randyzr/Graduation_Project/Project Tracking/README.md

# Seguimiento del proyecto

Este espacio resume el avance del proyecto de graduación y facilita su revisión por parte de la persona asesora y la persona lectora. La información se actualiza cada dos semanas y enlaza las afirmaciones de avance con evidencia verificable dentro del repositorio.

> **Estado de este tablero:** borrador inicial. Los porcentajes, fechas calendario y responsables deben confirmarse en la primera revisión con las personas profesoras.

## Resumen ejecutivo

| Elemento | Estado actual |
|---|---|
| Fecha de corte | 17 de agosto de 2026 |
| Última actualización | [Actualización 01](Biweekly%20Updates/2026-08-17_Update_01.md) |
| Periodicidad propuesta | Cada dos semanas |
| Estado general | Por confirmar con base en los entregables y la evidencia existente |
| Próximo hito | Por definir |
| Retroalimentación pendiente | Ver [seguimiento de retroalimentación](03_Feedback_Tracker.md) |

## Avance por objetivo

El porcentaje no se asigna por percepción. Se calcula con base en entregables terminados y aceptados. El detalle y el método de cálculo se encuentran en [avance por objetivos](01_Objective_Progress.md).

| Objetivo específico | Avance | Estado | Evidencia principal |
|---|---:|---|---|
| 1. Arquitectura e integración física | Por calcular | En revisión inicial | [Evidencia O1](Evidence/Objective%201/README.md) |
| 2. Identificación y adquisición ESD | Por calcular | En revisión inicial | [Evidencia O2](Evidence/Objective%202/README.md) |
| 3. Interfaz, almacenamiento y reportes | Por calcular | En revisión inicial | [Evidencia O3](Evidence/Objective%203/README.md) |
| 4. Validación funcional | Por calcular | En revisión inicial | [Evidencia O4](Evidence/Objective%204/README.md) |

## Accesos rápidos

- [Avance por objetivos](01_Objective_Progress.md)
- [Cronograma y principales hitos](02_Project_Schedule.md)
- [Seguimiento de retroalimentación](03_Feedback_Tracker.md)
- [Uso responsable de inteligencia artificial](04_Responsible_AI_Use.md)
- [Actualizaciones quincenales](Biweekly%20Updates/)
- [Evidencia organizada por objetivo](Evidence/)

## Criterios de estado

| Estado | Significado |
|---|---|
| No iniciado | No existe trabajo verificable del entregable |
| En progreso | Existe trabajo parcial y evidencia asociada |
| En revisión | El entregable está listo para recibir observaciones |
| Bloqueado | Existe un impedimento documentado |
| Completado | El criterio de aceptación fue verificado |

## Cómo revisar este espacio

1. Abrir la actualización quincenal más reciente.
2. Revisar los cambios en avance, cronograma, riesgos y retroalimentación.
3. Seguir los enlaces hacia la evidencia correspondiente.
4. Registrar nuevas observaciones en el seguimiento de retroalimentación.
