randyzr/Graduation_Project/Project Tracking/Evidence/Objective 1/README.md

# Evidencia del objetivo 1

Use este índice para enlazar evidencia existente sin duplicar innecesariamente archivos del repositorio.

| Entregable | Evidencia | Fecha | Estado de verificación |
|---|---|---|---|
| Requerimientos y criterios de diseño | Por enlazar | Por completar | Pendiente |
| Arquitectura y diagramas | Por enlazar | Por completar | Pendiente |
| Alimentación y pines | Por enlazar | Por completar | Pendiente |
| PCB | Por enlazar | Por completar | Pendiente |
| CAD y prototipo físico | Por enlazar | Por completar | Pendiente |
