randyzr/Graduation_Project/Documentation_Latex/body/glosario.tex

\chapter*{Glosario}
\addcontentsline{toc}{chapter}{Glosario}

\begin{description}

\item[ANSI] Instituto Nacional Estadounidense de Normalización.

\item[CDM] Modelo de dispositivo cargado.

\item[CSV] Valores separados por comas.

\item[EMI] Interferencia electromagnética.

\item[EPA] Área protegida contra descargas electrostáticas.

\item[ESD] Descarga electrostática.

\item[ESP-NOW] Protocolo de comunicación inalámbrica entre dispositivos de la familia ESP32.

\item[GPIO] Entrada o salida digital de propósito general.

\item[HBM] Modelo de cuerpo humano.

\item[HMI] Interfaz humano-máquina.

\item[HR] Humedad relativa.

\item[I2C] Bus de comunicación serial Inter-Integrated Circuit.

\item[IEC] Comisión Electrotécnica Internacional.

\item[JEDEC] Consejo Conjunto de Ingeniería de Dispositivos Electrónicos.

\item[MM] Modelo de máquina.

\item[PCB] Tarjeta de circuito impreso.

\item[RFID] Identificación por radiofrecuencia.

\item[RTC] Reloj de tiempo real.

\item[SD] Secure Digital.

\item[microSD] Factor de forma compacto del estándar SD.

\item[SPI] Interfaz periférica serial.

\item[TEM] Test, Engineering and Manufacturing.

\item[UART] Transmisor-receptor asíncrono universal.

\end{description}
