randyzr/Graduation_Project/Documentation_Latex/body/notation.tex

\chapter*{Notación}
\addcontentsline{toc}{chapter}{Notación}

\begin{description}

\item[$C$] Capacitancia.

\item[$f$] Frecuencia de la señal eléctrica.

\item[$I$] Corriente eléctrica.

\item[$I_{\mathrm{Body}}$] Corriente que circula a través del cuerpo del usuario durante la prueba.

\item[$I_{\mathrm{fuga}}$] Corriente de fuga presente en el circuito o en la tarjeta electrónica.

\item[$IF$] Tasa de integración funcional.

\item[$q$] Carga eléctrica.

\item[$R$] Resistencia eléctrica.

\item[$R_{\mathrm{Body}}$] Resistencia eléctrica del cuerpo del usuario a tierra.

\item[$R_{\mathrm{ref}}$] Resistencia de referencia utilizada en el circuito de medición.

\item[$TZ$] Índice de trazabilidad.

\item[$V$] Tensión eléctrica.

\item[$V_{\mathrm{Body}}$] Tensión medida en el cuerpo del usuario durante la prueba.

\item[$V_s$] Tensión de estímulo aplicada al circuito de medición.

\item[$X$] Reactancia eléctrica.

\item[$Z$] Impedancia eléctrica.

\item[$Z_{\mathrm{Cuerpo}}$] Impedancia eléctrica equivalente del cuerpo humano.

\end{description}
