randyzr/Graduation_Project/Documentation_Latex/body/Portada.tex

%% ---------------------------------------------------------------------------
%% titlepage_licce_es.tex
%%
%% Title page
%%
%% $Id: titlepage.tex 1452 2010-07-07 00:55:16Z palvarado $
%% ---------------------------------------------------------------------------

\thispagestyle{empty} 

\begin{center}

Tecnológico de Costa Rica

\par\vspace{1ex}

Escuela de Ingeniería Electrónica

\par\vspace{1ex}

Programa de Licenciatura en Ingeniería Electrónica

\par\vspace{20mm}



\par\vspace*{\fill}

{\large\bf{\thesisTitle}}

\par\vspace*{\fill}

Informe de Proyecto de Graduación para optar por el título de

Ingeniero en Electrónica con el grado académico de Licenciatura

\par\vspace{20mm}

\thesisAuthor 

Asesor: M.Sc.-Ing.\, Javier Rivera Alvarado

Campus Tecnológico Local San Carlos

\vspace*{\fill}

\ifdraft{%
{ \today}
}{
San Carlos,  Mayo, 2026
}
\end{center}
\newpage 
\cleardoublepage 

%%% Local Variables: 
%%% mode: latex
%%% TeX-master: "main"
%%% End:
