randyzr/Graduation_Project/Project Tracking/Evidence/Objective 2/README.md

# Evidencia del objetivo 2

| Entregable | Evidencia | Fecha | Estado de verificación |
|---|---|---|---|
| Flujo de identificación y adquisición | Por enlazar | Por completar | Pendiente |
| Código de barras | Por enlazar | Por completar | Pendiente |
| Reconocimiento facial | Por enlazar | Por completar | Pendiente |
| Estados `LO`, `OK` y `HI` | Por enlazar | Por completar | Pendiente |
| Pruebas funcionales | Por enlazar | Por completar | Pendiente |
