randyzr/Graduation_Project/Project Tracking/Evidence/Objective 3/README.md

# Evidencia del objetivo 3

| Entregable | Evidencia | Fecha | Estado de verificación |
|---|---|---|---|
| Interfaz gráfica | Por enlazar | Por completar | Pendiente |
| Flujo y estructura de datos | Por enlazar | Por completar | Pendiente |
| Almacenamiento, consulta y reportes | Por enlazar | Por completar | Pendiente |
| Pruebas funcionales | Por enlazar | Por completar | Pendiente |
