randyzr/Graduation_Project/Project Tracking/Evidence/Objective 4/README.md

# Evidencia del objetivo 4

| Entregable | Evidencia | Fecha | Estado de verificación |
|---|---|---|---|
| Procedimiento y criterios | Por enlazar | Por completar | Pendiente |
| Evaluación de pruebas individuales | Por enlazar | Por completar | Pendiente |
| Pruebas de integración | Por enlazar | Por completar | Pendiente |
| Cálculos de `TZ` e `IF` | Por enlazar | Por completar | Pendiente |
| Informe de validación | Por enlazar | Por completar | Pendiente |
