randyzr/Graduation_Project/Project Tracking/02_Project_Schedule.md

# Cronograma

| Actividad | Inicio | Fin estimado | Duración | Objetivo relacionado | Estado actual |
|---|---:|---:|---:|---|---|
| Prototipo versión 2.0 terminado | Semana 3 | Semana 9 | 7 semanas | O1–O3 | Por actualizar |
| Desarrollo general del proyecto | Semana 3 | Semana 14 | 12 semanas | O1–O4 | Por actualizar |
| Informe preliminar del proyecto | Semana 5 | Semana 10 | 6 semanas | O1–O3 | Por actualizar |
| Pruebas en laboratorio TEM | Semana 9 | Por definir | Por definir | O4 | Por actualizar |
