randyzr/Graduation_Project/Project Tracking/01_Objective_Progress.md

# Avance por objetivos

Fuente de los objetivos y entregables: `Documentation/GP_Official_Doc/body/Hipot_y_Obj.tex`.

## Método de medición

Cada entregable tiene el mismo peso dentro de su objetivo en este primer borrador. El porcentaje se calcula así:

```text
avance del objetivo = entregables completados / entregables totales × 100
```

## Objetivo específico 1

**Objetivo:** Diseñar la arquitectura electrónica, de comunicación, alimentación e integración física de la estación, con base en los requerimientos funcionales y no funcionales del sistema.

| Entregable | Criterio de aceptación propuesto | Estado | Evidencia | Observaciones |
|---|---|---|---|---|
| Especificación de requerimientos y criterios de diseño | Requerimientos identificables, verificables y relacionados con el diseño | Por revisar | [Evidencia O1](Evidence/Objective%201/README.md) | Confirmar evidencia existente |
| Arquitectura electrónica y diagramas de bloques e interconexión | Subsistemas, interfaces y protocolos claramente identificados | Por revisar | [Evidencia O1](Evidence/Objective%201/README.md) | |
| Sistema de alimentación y distribución de pines | Tensiones, protecciones, consumo y pines documentados | Por revisar | [Evidencia O1](Evidence/Objective%201/README.md) | |
| PCB diseñadas, fabricadas y verificadas | Archivos de diseño y resultados de verificación eléctrica disponibles | Por revisar | [Evidencia O1](Evidence/Objective%201/README.md) | |
| Modelo CAD y prototipo físico ensamblado | Modelo disponible y ensamblaje documentado con evidencia visual | Por revisar | [Evidencia O1](Evidence/Objective%201/README.md) | |

**Avance calculado:** por determinar después de revisar la evidencia.

## Objetivo específico 2

**Objetivo:** Diseñar e implementar los subsistemas de identificación de usuarios y adquisición del resultado de la prueba ESD, mediante la integración del lector de código de barras, el reconocimiento facial complementario y las señales del probador HZR-171.

| Entregable | Criterio de aceptación propuesto | Estado | Evidencia | Observaciones |
|---|---|---|---|---|
| Flujo de identificación y adquisición ESD documentado | El flujo y sus estados pueden seguirse de inicio a fin | Por revisar | [Evidencia O2](Evidence/Objective%202/README.md) | Confirmar evidencia existente |
| Identificación por código de barras funcional | Se lee y valida el identificador en pruebas documentadas | Por revisar | [Evidencia O2](Evidence/Objective%202/README.md) | |
| Reconocimiento facial complementario | Registro y reconocimiento funcionan bajo condiciones documentadas | Por revisar | [Evidencia O2](Evidence/Objective%202/README.md) | |
| Adquisición de estados `LO`, `OK` y `HI` | Cada estado se adquiere y reporta correctamente en pruebas | Por revisar | [Evidencia O2](Evidence/Objective%202/README.md) | |
| Pruebas funcionales de identificación y adquisición | Resultados, incidencias y conclusiones están documentados | Por revisar | [Evidencia O2](Evidence/Objective%202/README.md) | |

**Avance calculado:** por determinar después de revisar la evidencia.

## Objetivo específico 3

**Objetivo:** Diseñar e implementar la interfaz gráfica que guíe al usuario durante el ciclo de prueba y el sistema de almacenamiento de los resultados y generación de reportes históricos trazables.

| Entregable | Criterio de aceptación propuesto | Estado | Evidencia | Observaciones |
|---|---|---|---|---|
| Interfaz gráfica táctil funcional | El usuario completa el flujo previsto y recibe mensajes claros | Por revisar | [Evidencia O3](Evidence/Objective%203/README.md) | Confirmar evidencia existente |
| Flujo de interacción y estructura de datos documentados | Estados, transiciones y campos del registro están definidos | Por revisar | [Evidencia O3](Evidence/Objective%203/README.md) | |
| Almacenamiento, consulta y reportes históricos | Los registros completos pueden guardarse, consultarse y exportarse | Por revisar | [Evidencia O3](Evidence/Objective%203/README.md) | |
| Pruebas funcionales de interacción y gestión de información | Resultados, incidencias y conclusiones están documentados | Por revisar | [Evidencia O3](Evidence/Objective%203/README.md) | |

**Avance calculado:** por determinar después de revisar la evidencia.

## Objetivo específico 4

**Objetivo:** Validar el desempeño funcional del prototipo mediante pruebas individuales de los subsistemas y pruebas de integración del sistema completo, utilizando los indicadores de trazabilidad e integración funcional definidos para el proyecto.

| Entregable | Criterio de aceptación propuesto | Estado | Evidencia | Observaciones |
|---|---|---|---|---|
| Procedimiento y criterios de aceptación | Casos, datos, ambiente, pasos y criterios están definidos antes de validar | Por revisar | [Evidencia O4](Evidence/Objective%204/README.md) | Confirmar evidencia existente |
| Evaluación consolidada de pruebas individuales | Los resultados de los subsistemas se resumen y analizan | Por revisar | [Evidencia O4](Evidence/Objective%204/README.md) | |
| Pruebas de integración documentadas | Existen resultados reproducibles del ciclo completo | No iniciado | [Evidencia O4](Evidence/Objective%204/README.md) | Confirmar fecha y laboratorio |
| Índices `TZ` e `IF` calculados | Datos, fórmulas, cálculos y resultados son trazables | No iniciado | [Evidencia O4](Evidence/Objective%204/README.md) | |
| Informe de validación | Incluye cumplimiento, incidencias, limitaciones y conclusiones | No iniciado | [Evidencia O4](Evidence/Objective%204/README.md) | |

**Avance calculado:** por determinar después de revisar la evidencia.
