randyzr/Graduation_Project/Documentation_Latex/main.tex

%%%%%%%%%%%%%%%%%%%%%%%%%%%%%%%%%%%%%%%%%%%%%%%%%%%%%%%%%%%%%%%%%%%%%%%%%%%%%%%
% Author:  Pablo Alvarado
%
% Escuela de Ingeniería Electrónica
% Instituto Tecnológico de Costa Rica
%
% Tesis de Licenciatura
% 
% Phone:   +506 2550 9005
% email:   palvarado@itcr.ac.cr
%
%%%%%%%%%%%%%%%%%%%%%%%%%%%%%%%%%%%%%%%%%%%%%%%%%%%%%%%%%%%%%%%%%%%%%%%%%%%%%%%

% \documentclass is book
% If you want a printable two-side version of the thesis
%\documentclass[12pt,twoside,letterpaper]{book}

% If you want an electronic-only version of the thesis, do it one-sided
\documentclass[12pt,oneside,letterpaper]{book}

\usepackage[utf8]{inputenc}
\usepackage{ifthen}       % provide if-then-else operators
\usepackage{subcaption}
\usepackage[siunitx]{circuitikz}
\usepackage{siunitx}
\usepackage{tabularx}
\usepackage{float}
\usepackage{array}
\usepackage{pgfgantt}
\usepackage{pdflscape}
\usepackage{xcolor}
\usepackage{rotating}
\usepackage{booktabs}

\usepackage[backend=biber]{biblatex}
\addbibresource{literatura.bib}
%\addbibresource{literatura.bib}z
% --------------------------------------------------------------------------
% Global variables required in document formatting
% --------------------------------------------------------------------------
%
% BOOK MODE
%
\newboolean{bookmode}                  % boolean used to control book format
% Ensure that only one of the next two lines is active:
\setboolean{bookmode}{true}           % turn book mode on
%\setboolean{bookmode}{false}           % turn book mode off

%
% DRAFT MODE
%   The draft mode activates the TODO index and some "draft" markings all
%   around.  Ensure you set it to false for the final version!!
%
\newboolean{draftmode}                  % boolean used to control draft-mode
% Ensure that only one of the next two lines is active:
\setboolean{draftmode}{true}            % turn draft mode on
%\setboolean{draftmode}{false}           % turn draft mode off
% --------------------------------------------------------------------------
%
% GENERAL AUTHOR, TITLE AND KEYWORDS
%
% Nombre del Estudiante
\newcommand{\thesisAuthorAddress}{el señor} %% el señor / la señora / ...
\newcommand{\thesisAuthor}{Randy Zamora Rojas} %% Nombre completo
\newcommand{\thesisAuthorShort}{R.~Zamora}  %% Nombre corto para pie de página
\newcommand{\thesisAuthorTECID}{ } %% Carné

% Título de la tesis
\newcommand{\thesisTitle}{Diseño e implementación de un sistema inteligente de bajo costo para el control ESD en laboratorios de electrónica}

% Keywords
\newcommand{\thesisKeywords}{ESD, descarga electrostática, alta impedancia, resistencia cuerpo-tierra, sistema inteligente, bajo costo}

% Tipo de tesis o informe
%   - Tesis de Licenciatura
%   - Informe de Proyecto Final 
%   - Tesis de Maestría
\newcommand{\thesisType}{Informe de Proyecto Final}

% Descripción de la editorial
\newcommand{\boxeditorial}{%
}

% Para el PDF (cambiar si se desea otras cosas a lo indicado arriba
\newcommand{\pdfAuthor}{\thesisAuthor}
\newcommand{\pdfTitle}{\thesisTitle} 
\newcommand{\pdfKeywords}{\thesisKeywords}
\newcommand{\pdfSubject}{\thesisType}
% --------------------------------------------------------------------------

% include all packages and define all required general macros
\input{body/macros}

% Tribunal Evaluador
%
% Indique los nombres de los lectores y asesor
% El parámetro opcional es [M]asculino o [F]emenino

\setLectorI[F]{Ing. Marian Rojas Rojas}
\setLectorII{Por definir}
\setAsesor{M.Sc.-Ing.\, Javier Rivera Alvarado}

% allow equations to be splitted (breaked) into several pages
\allowdisplaybreaks[3]

% --------------------------------------------------------------------------
\begin{document}
  % where to look for graphics
    \graphicspath{{./}{./pics/}{pics/}}

    \pagenumbering{alph}
  % fix some terms not activated due to the bug of hyperref with spanish.
  \renewcommand{\tablename}{Tabla}
  \renewcommand{\listtablename}{Índice de tablas}
  \renewcommand{\examplesolution}{Solución}
  \pagestyle{empty}

  % select one of the following titlepages
  
  \include{body/Portada} % Titlepage in Spanish
  \include{body/Declaratoria}
  
  %% -------------------------------------------------
  
  %% Para la licenciatura en electrónica:
  \include{body/tribunal_licel}  % Remover en versión final
  \include{body/acta_licel}      % Remover en versión final
  
  %% Para la maestría en electrónica:
  %\include{tribunal_mscel}  % Remover en versión final
  %\include{acta_mscel}      % Remover en versión final
  
  %% -------------------------------------------------
  
  \include{body/Resumen}
  \include{body/Dedicatoria}
  \include{body/Agradecimientos}

  %----------------------------------------------------------------------------
  \pagestyle{fancy}
  \pagenumbering{roman}

  \pdfbookmark[1]{Indice General}{Indice General}

  \parskip0ex                           % space between paragraphs

  \tableofcontents                      % Table of contents
  \listoffigures                        % List of figures
  \listoftables                         % List of tables

  \include{body/notation}                    % Notation
  \include{body/glosario}                    % Abbreviation

  \parskip1.3ex                         % space between paragraphs

  %----------------------------------------------------------------------------
  \mainmatter%
  %----------------------------------------------------------------------------
  % where to look for graphics
  \graphicspath{{./}{./pics/}{pics/}}
  %\pagenumbering{arab}
  
  % Main files
  \include{body/Introduccion}
  \include{body/Marco_Teorico}
  \include{body/Estado_Arte}
  \include{body/Meta_y_Objetivos}
  \include{body/Descripcion_Detallada_Solucion}
  \include{body/Presupuesto}
  \include{body/Metodologia}
  \include{body/Analisis_Resultados}
  \include{body/Conclusiones_Recomendaciones}

  %----------------------------------------------------------------------------
  % literature in bibtex way:
  % \bibliographystyle{sty/plainurl} % for english documents
  % \bibliography{literatura}
  % literature in biblatex/biber way
  \printbibliography[title={Bibliografía},heading=bibintoc]
  %----------------------------------------------------------------------------

  %----------------------------------------------------------------------------
  \appendix
  %----------------------------------------------------------------------------

  %----------------------------------------------------------------------------
  \backmatter%
  %----------------------------------------------------------------------------

  \printindex                % insert index into document. Don't forget to call
                             % "makeindex filename" first.
                             
\end{document}
