randyzr/Graduation_Project/Documentation_Latex/body/acta_licel.tex

%% ESTE ARCHIVO DEBE ELIMINARSE DE LA VERSIÓN FINAL

\thispagestyle{empty}

\begin{center}
  \begin{tabular}{c}
    Instituto Tecnológico de Costa Rica \\
    Escuela de Ingeniería Electrónica \\
    Proyecto de Graduación \\
    Tribunal Evaluador \\
    Acta de Evaluación
  \end{tabular}
\end{center}

\vfill

\begin{center}
  \begin{tabular}{c}
    Defensa de Proyecto de Graduación \\
    Requisito para optar por el título de Ingeniero en Electrónica \\
    Grado Académico de Licenciatura
  \end{tabular}
\end{center}

\vfill

%% \thesisAuthorAddress, \thesisAuthor y \thesisTitle están en main.tex
\begin{center}

  Estudiante:%
  \qquad \textbf{\thesisAuthor}%
  \qquad Carné: 2021439867\thesisAuthorTECID

  \vspace*{2ex}

  \setlength\tabcolsep{0pt}
  \begin{tabular}{p{.25\textwidth}p{.73\textwidth}}
    Nombre del proyecto: & \textsl{\thesisTitle}
  \end{tabular}
\end{center}
\vspace{5mm}

\vfill

Los miembros de este Tribunal hacen constar que este proyecto de
graduación ha sido aprobado y cumple con las normas establecidas por
la Escuela de Ingeniería Electrónica del Instituto Tecnológico de
Costa Rica y es merecedor de la siguiente calificación:

\vfill

\begin{center}
  Nota de Proyecto de Graduación: \rule{25mm}{0.5pt}
\end{center}

\vfill

\begin{center}
 Miembros del Tribunal Evaluador
\end{center}

\vfill

% Defina con \setLector* en main.tex (líneas 87-89) los lectores y asesor
\begin{center}
  \begin{tabularx}{\textwidth}{cXc}
    \rule{0.45\textwidth}{0.5pt} && \rule{0.45\textwidth}{0.5pt} \\
    \nameAsesor                 && \nameLectorI \\
    \genderAsesor               && \genderLectorI
  \end{tabularx}
  
\end{center}

\vfill

\begin{center}
  San Carlos, \today\par
\end{center}

\cleardoublepage

%%% Local Variables: 
%%% mode: latex
%%% TeX-master: "main"
%%% End:
