randyzr/Graduation_Project/Documentation_Latex/body/Descripcion_Detallada_Solucion.tex

\chapter{Descripción detallada de la solución}
