randyzr/Graduation_Project/Documentation_Latex/body/tribunal_licel.tex

%% ESTE ARCHIVO DEBE ELIMINARSE DE LA VERSIÓN FINAL

\thispagestyle{empty}

\begin{center}
  \begin{tabular}{c}
    Instituto Tecnológico de Costa Rica \\
    Escuela de Ingeniería Electrónica \\
    Proyecto de Graduación \\
    Acta de Aprobación
  \end{tabular}
\end{center}

\vfill

\begin{center}
  \begin{tabular}{c}
    Defensa de Proyecto de Graduación \\
    Requisito para optar por el título de Ingeniero en Electrónica \\
    Grado Académico de Licenciatura
  \end{tabular}
\end{center}

\vfill

%% \thesisAuthorAddress, \thesisAuthor y \thesisTitle están en main.tex
El Tribunal Evaluador aprueba la defensa del proyecto de graduación
denominado \textsl{\thesisTitle}, realizado por
%
\thesisAuthorAddress\ \thesisAuthor\ %
%
y, hace constar que cumple con las normas
establecidas por la Escuela de Ingeniería Electrónica del Instituto
Tecnológico de Costa Rica.

\vfill

\begin{center}
 Miembros del Tribunal Evaluador
\end{center}

\vfill

\begin{center}
  \begin{tabularx}{\textwidth}{cXc}
    \rule{0.45\textwidth}{0.5pt} && \rule{0.45\textwidth}{0.5pt} \\
    \nameAsesor                 && \nameLectorI \\
    \genderAsesor               && \genderLectorI
  \end{tabularx}
  
\end{center}

\vfill

\begin{center}
  San Carlos, \today\par
\end{center}

\cleardoublepage

%%% Local Variables: 
%%% mode: latex
%%% TeX-master: "main"
%%% End:
