randyzr/Graduation_Project/Documentation_Latex/body/Agradecimientos.tex

\chapter*{Agradecimientos}

% Agregar agradecimientos en la versión final.
