randyzr/Graduation_Project/Documentation_Latex/body/Dedicatoria.tex

\chapter*{Dedicatoria}

% Agregar dedicatoria en la versión final.
