randyzr/Graduation_Project/Prototype Development/Diagrams/Circuitikz/BodyResistence/main.pdf

Rref

Vbody

A

B

Señal de
estímulo

1
