randyzr/Graduation_Project/Documentation_Latex/pics/SP_05.png

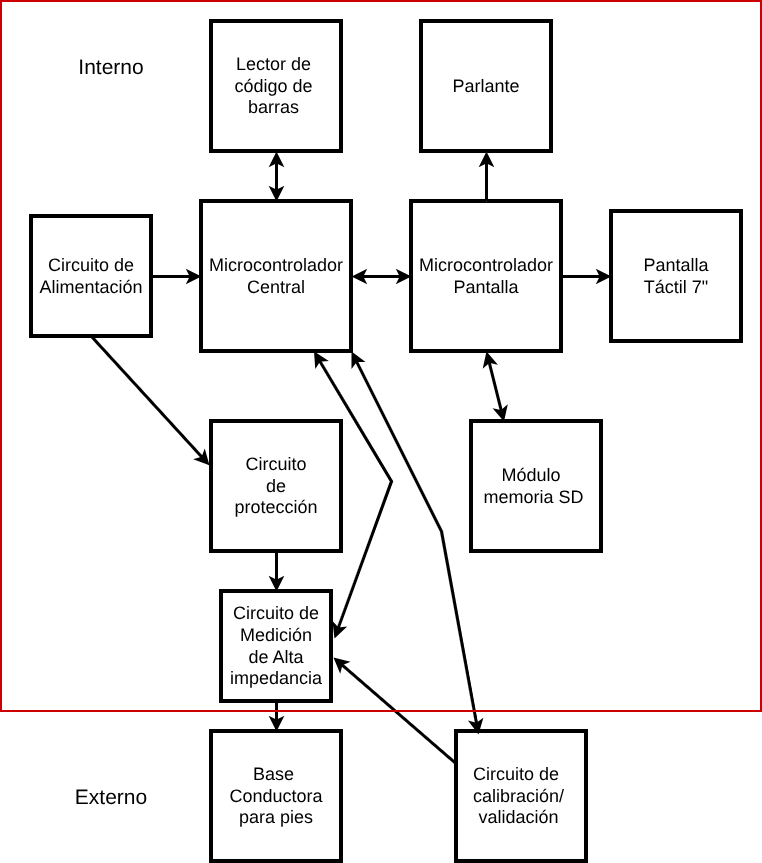
Documentation_Latex/pics/SP_05.png
