randyzr/Graduation_Project/Documentation_Latex/pics/SP_08.png

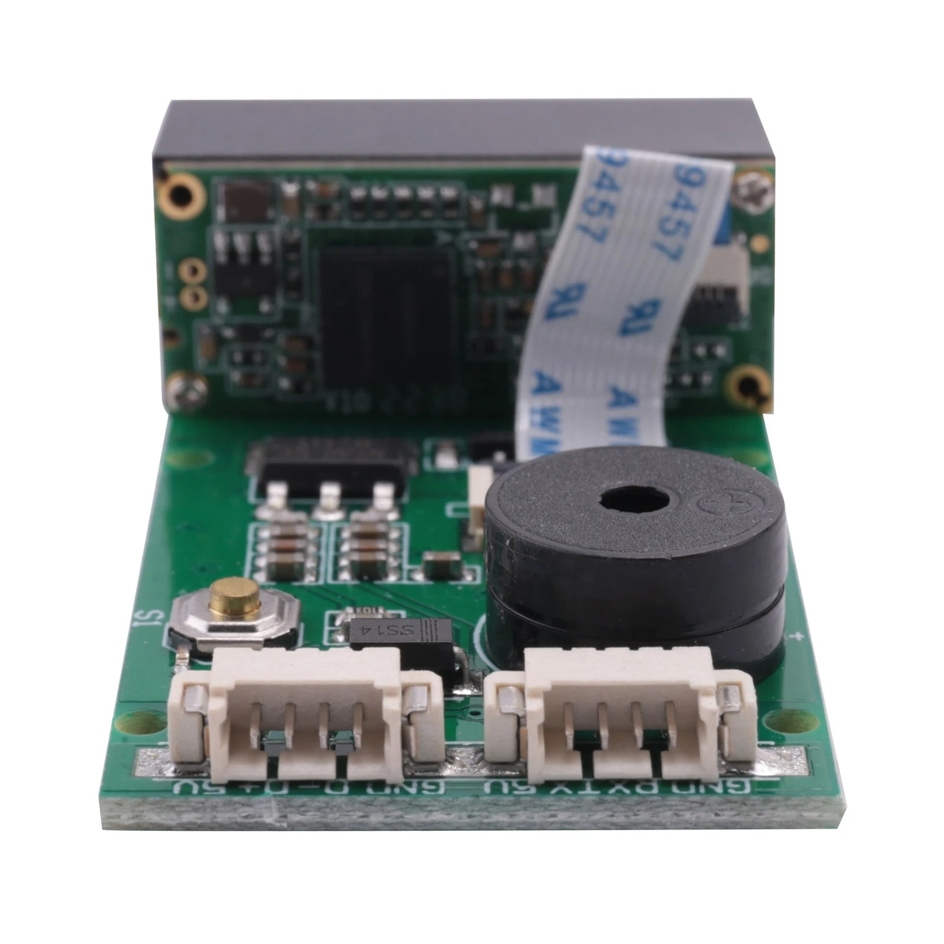
Documentation_Latex/pics/SP_08.png
