randyzr/Graduation_Project/Documentation_Latex/pics/SP_09.jpg

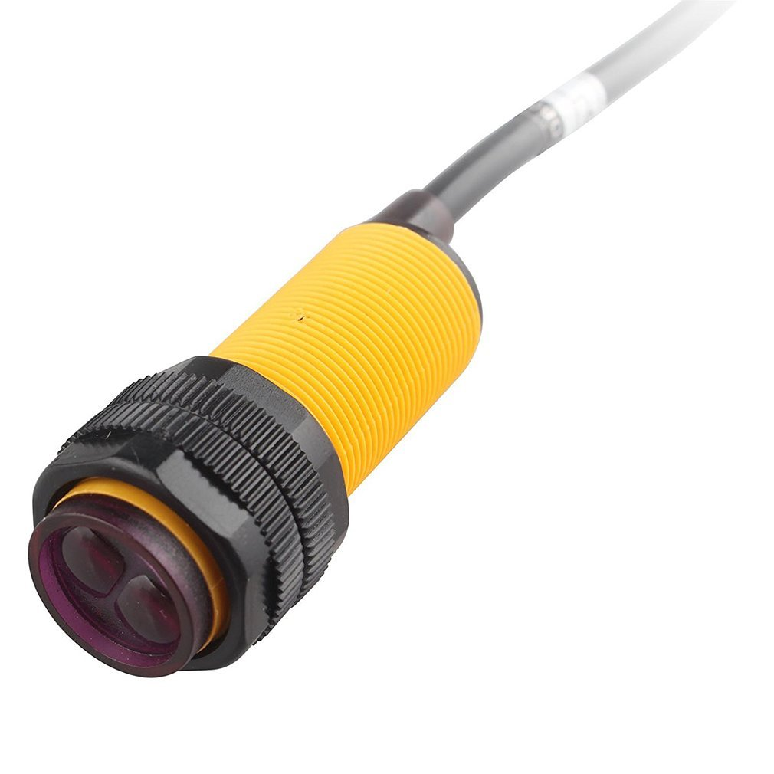
Documentation_Latex/pics/SP_09.jpg
