randyzr/Graduation_Project/Documentation_Latex/pics/SP_11.jpg

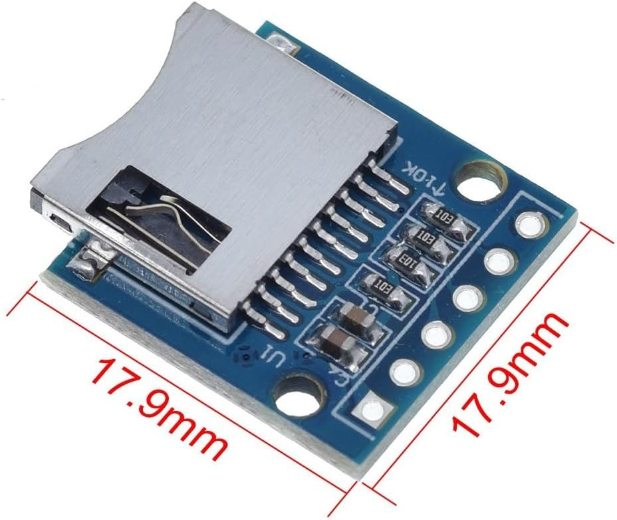
Documentation_Latex/pics/SP_11.jpg
