randyzr/Graduation_Project/Documentation_Latex/pics/SP_14.jpg

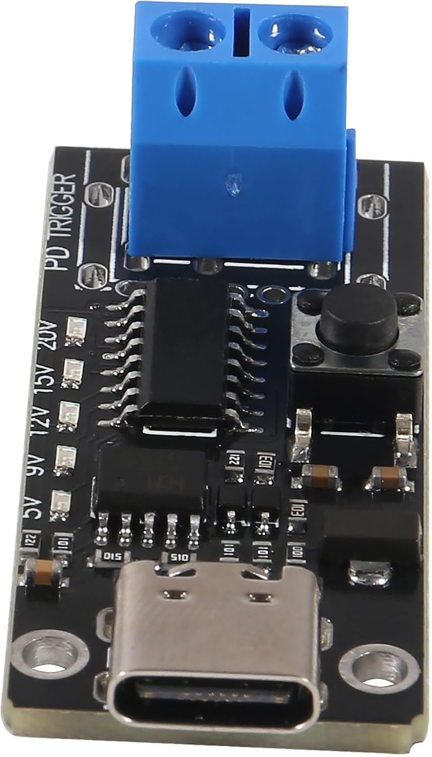
Documentation_Latex/pics/SP_14.jpg
