randyzr/Graduation_Project/Documentation_Latex/pics/SP_17.png

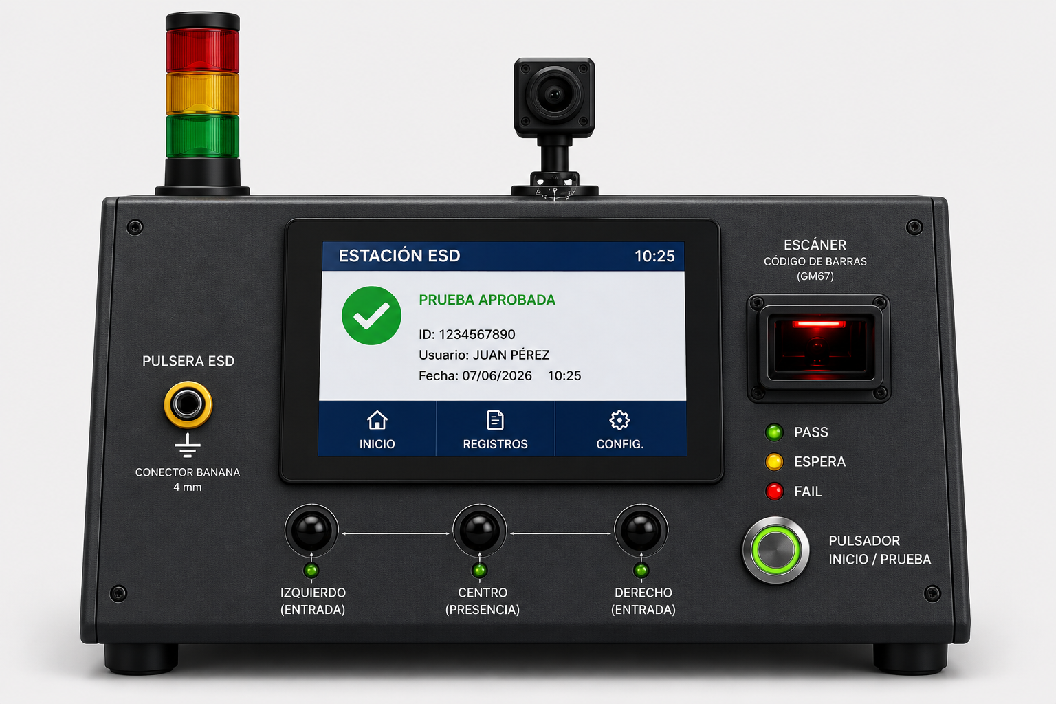
Documentation_Latex/pics/SP_17.png
