randyzr/Graduation_Project/Documentation_Latex/pics/TF3_1.png

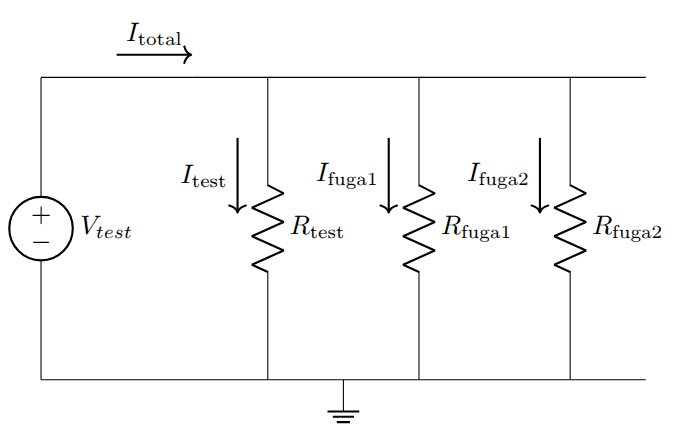
Documentation_Latex/pics/TF3_1.png
