randyzr/Graduation_Project/Documentation_Latex/pics/TF3_2.png

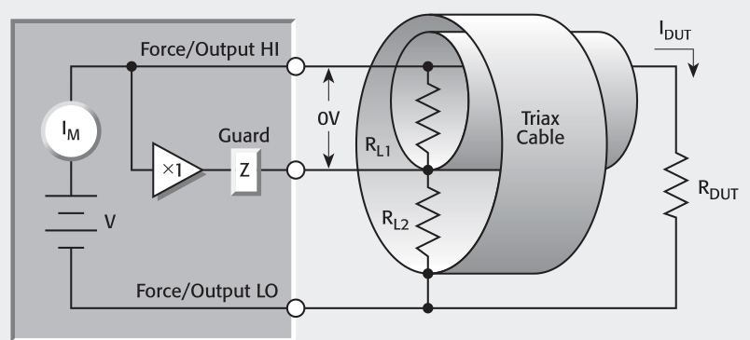
Documentation_Latex/pics/TF3_2.png
