randyzr/Graduation_Project/Documentation_Latex/pics/TF3_3.png

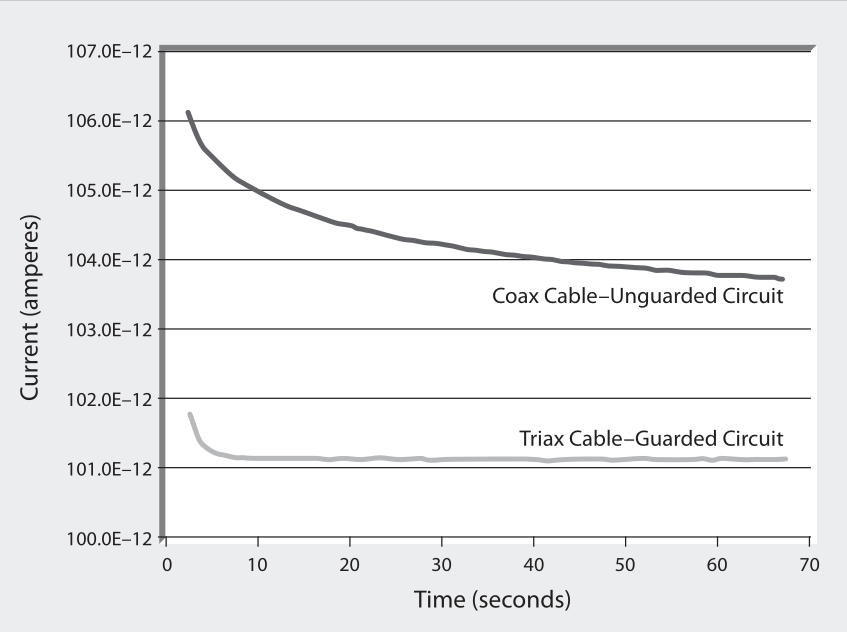
Documentation_Latex/pics/TF3_3.png
