randyzr/Graduation_Project/Documentation_Latex/pics/TF3_5.png

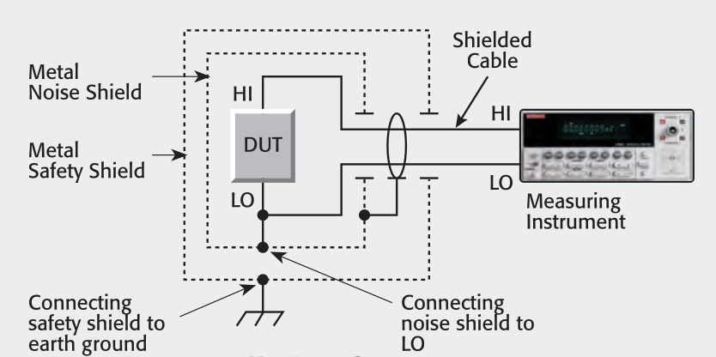
Documentation_Latex/pics/TF3_5.png
