randyzr/Graduation_Project/Documentation_Latex/pics/TF3_6.png

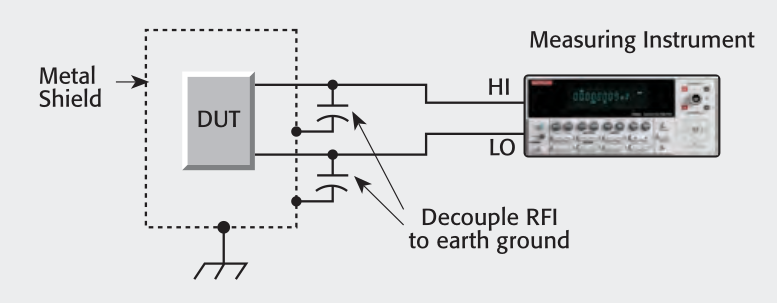
Documentation_Latex/pics/TF3_6.png
