randyzr/Graduation_Project/Documentation_Latex/pics/TF4_1.png

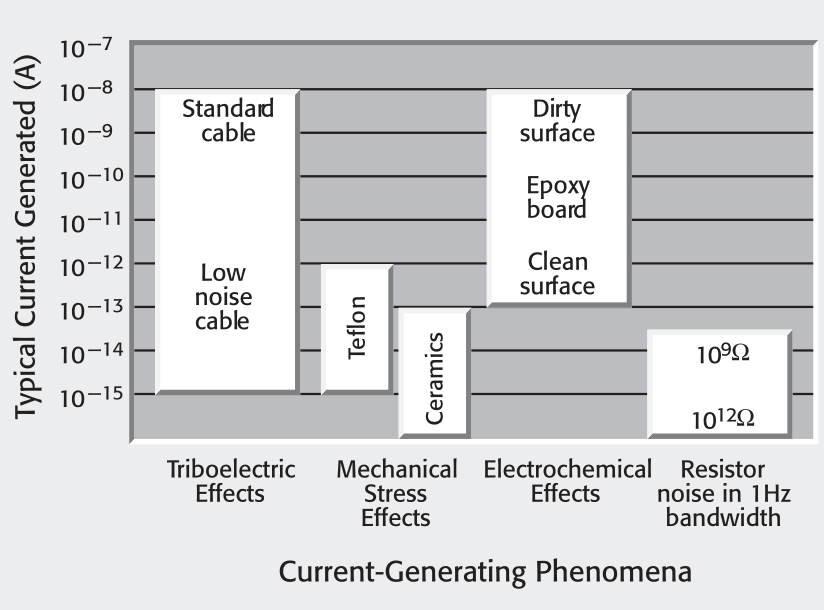
Documentation_Latex/pics/TF4_1.png
