randyzr/Graduation_Project/Documentation_Latex/pics/TF4_2.png

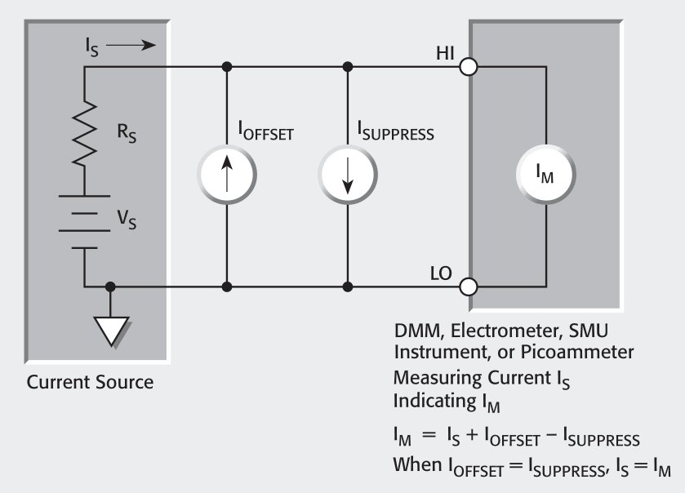
Documentation_Latex/pics/TF4_2.png
