randyzr/Graduation_Project/Documentation_Latex/pics/TF4_3.png

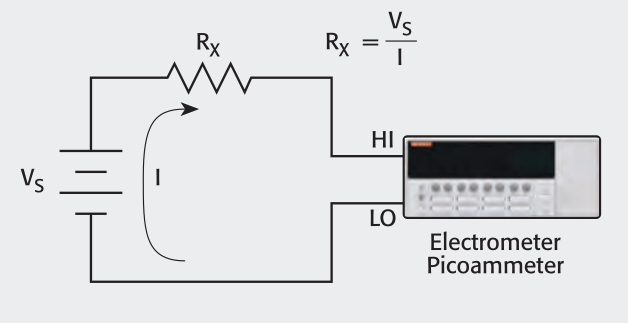
Documentation_Latex/pics/TF4_3.png
