randyzr/Graduation_Project/Documentation_Latex/pics/TF4_4.png

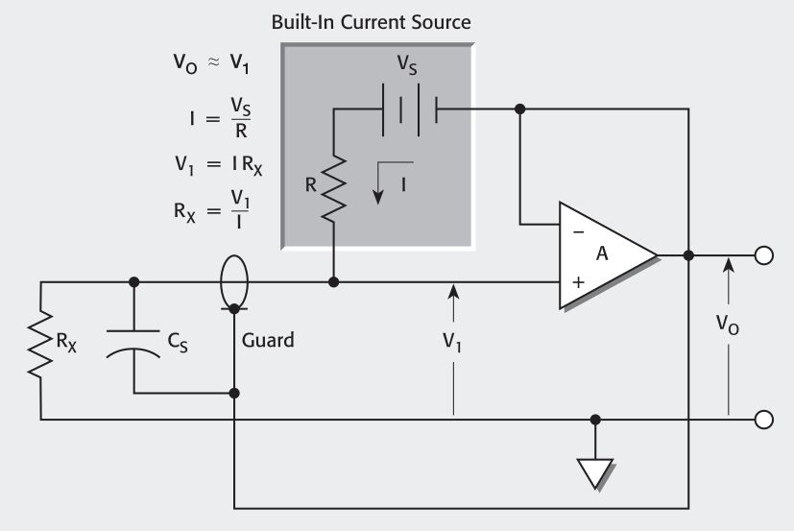
Documentation_Latex/pics/TF4_4.png
