randyzr/Graduation_Project/Documentation_Latex/pics/TF4_5.png

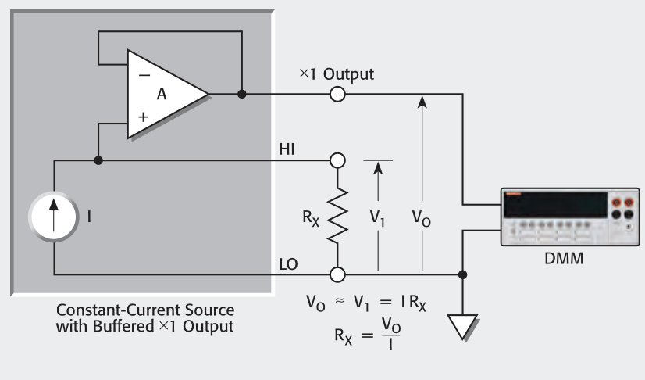
Documentation_Latex/pics/TF4_5.png
