randyzr/Graduation_Project/Documentation_Latex/pics/TF4_7.png

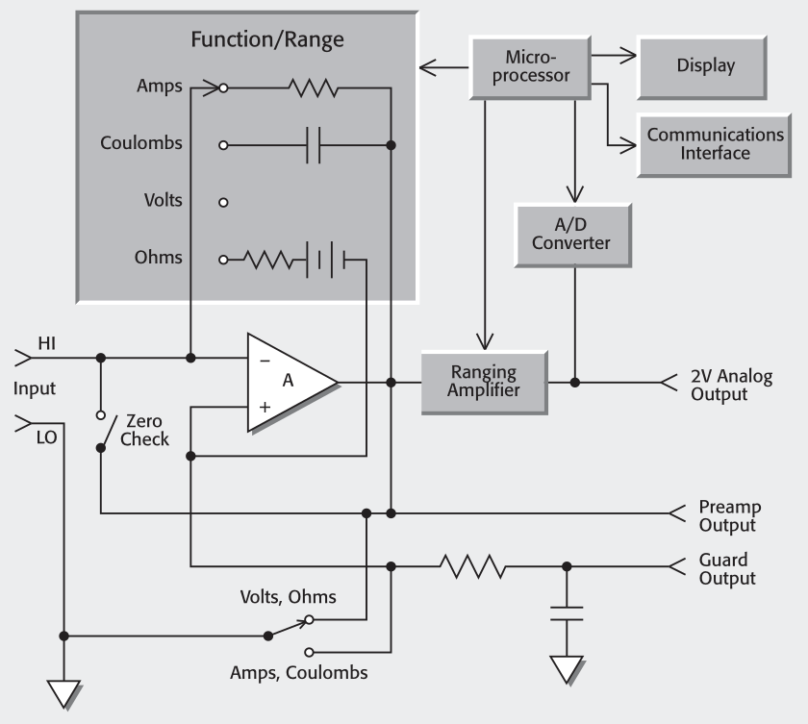
Documentation_Latex/pics/TF4_7.png
