randyzr/Graduation_Project/Documentation_Latex/pics/TF_05.png

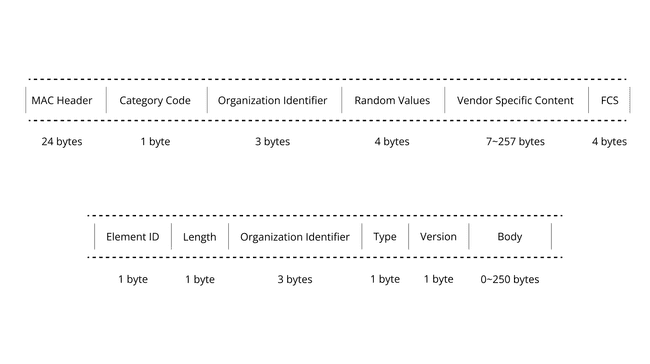
Documentation_Latex/pics/TF_05.png
