randyzr/Graduation_Project/Presentation_Beamer/Figures/F4.webp

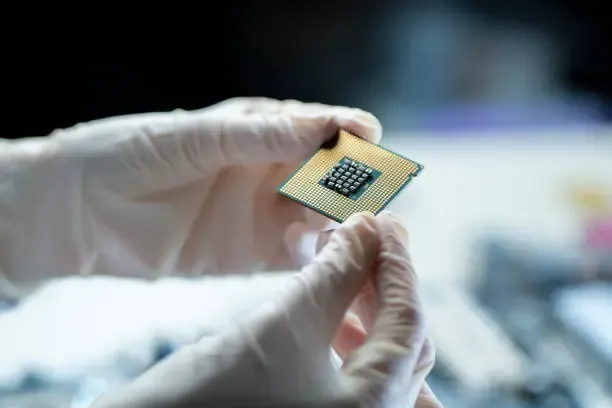
Presentation_Beamer/Figures/F4.webp
