randyzr/Graduation_Project/Presentation_Beamer/Figures/F5.png

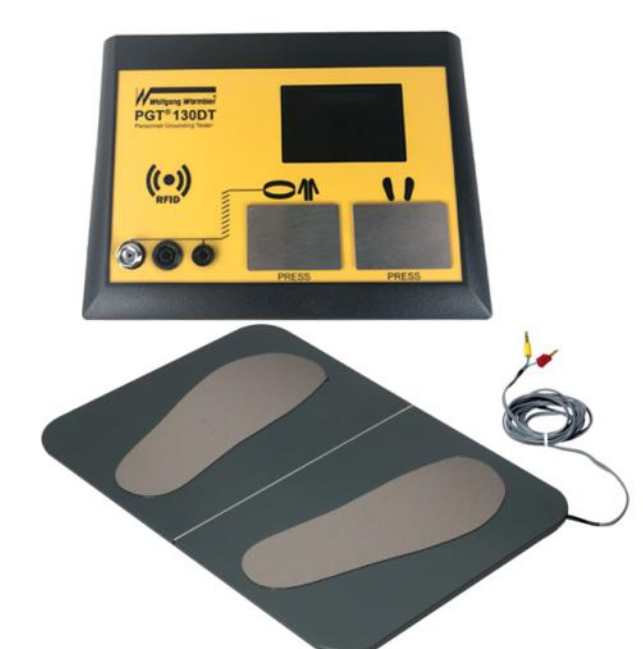
Presentation_Beamer/Figures/F5.png
