randyzr/Graduation_Project/Presentation_Beamer/Figures/F6.png

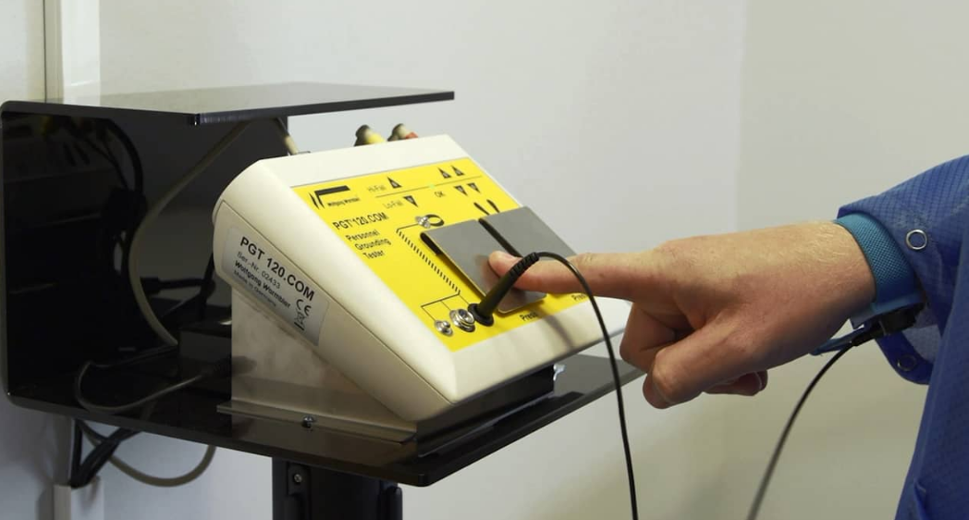
Presentation_Beamer/Figures/F6.png
