randyzr/Graduation_Project/Presentation_Beamer/Figures/F8.png

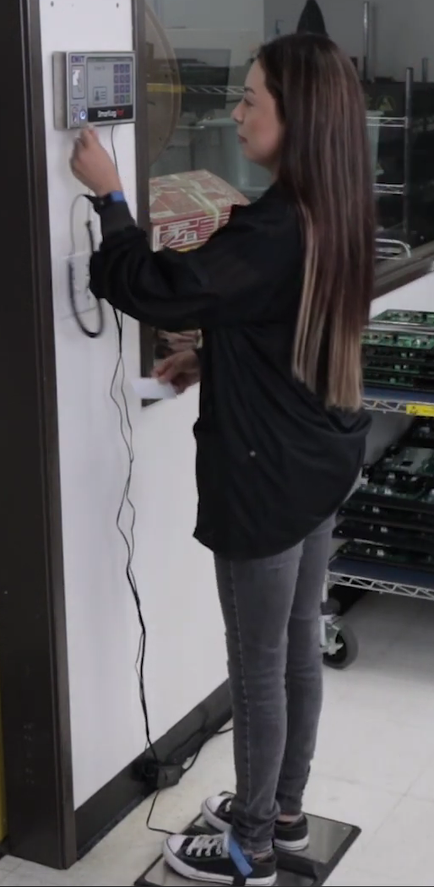
Presentation_Beamer/Figures/F8.png
