randyzr/Graduation_Project/Presentation_Beamer/Figures/F11.png

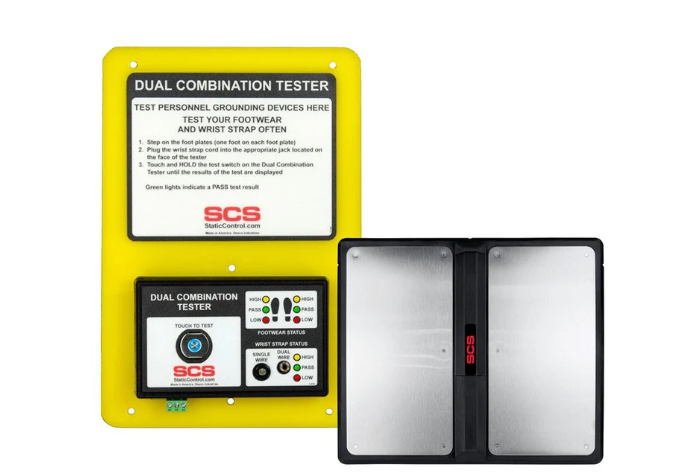
Presentation_Beamer/Figures/F11.png
