randyzr/Graduation_Project/Presentation_Beamer/Figures/F12.png

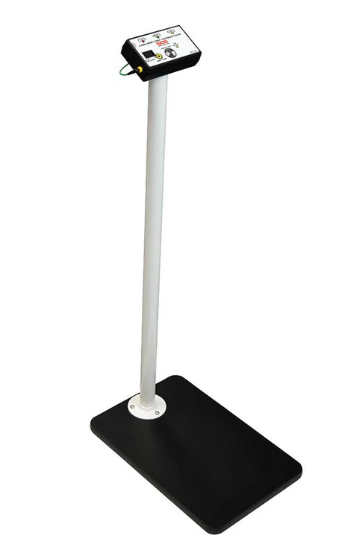
Presentation_Beamer/Figures/F12.png
