randyzr/Graduation_Project/Presentation_Beamer/Figures/F13.png

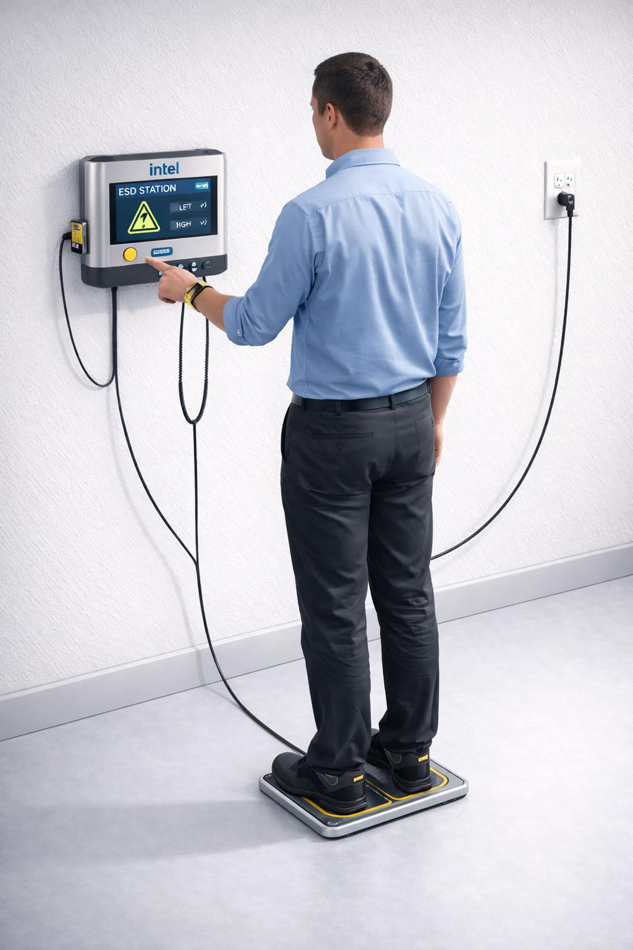
Presentation_Beamer/Figures/F13.png
