randyzr/Graduation_Project/Presentation_Beamer/Figures/F16.webp

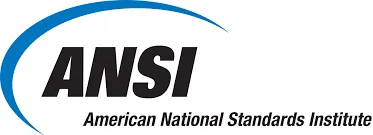
Presentation_Beamer/Figures/F16.webp
