randyzr/Graduation_Project/Prototype Development/Datasheets/ESP32-Pinout.webp

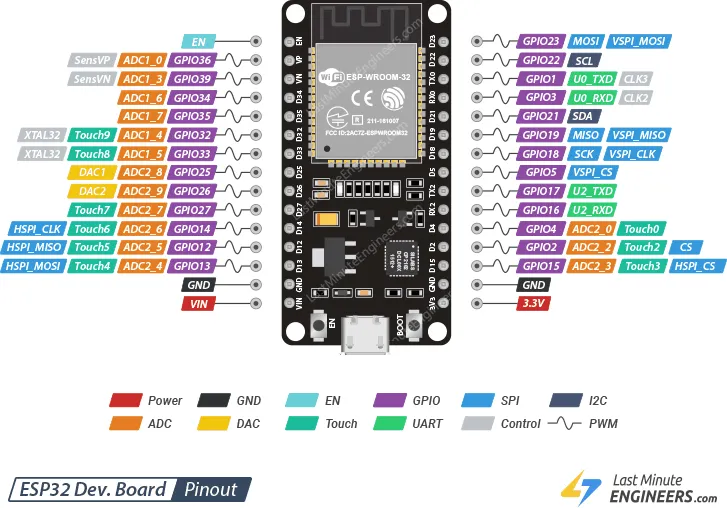
Prototype Development/Datasheets/ESP32-Pinout.webp
