randyzr/Graduation_Project/Prototype Development/Tracking/PrototypeDraftV1.0.jpeg

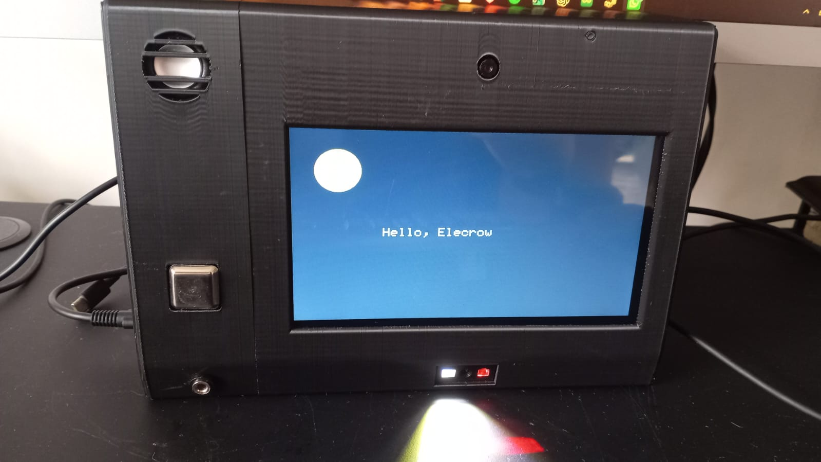
Prototype Development/Tracking/PrototypeDraftV1.0.jpeg
