randyzr/Graduation_Project/Prototype Development/3D Design/Version1p0/ESFGP02.stl

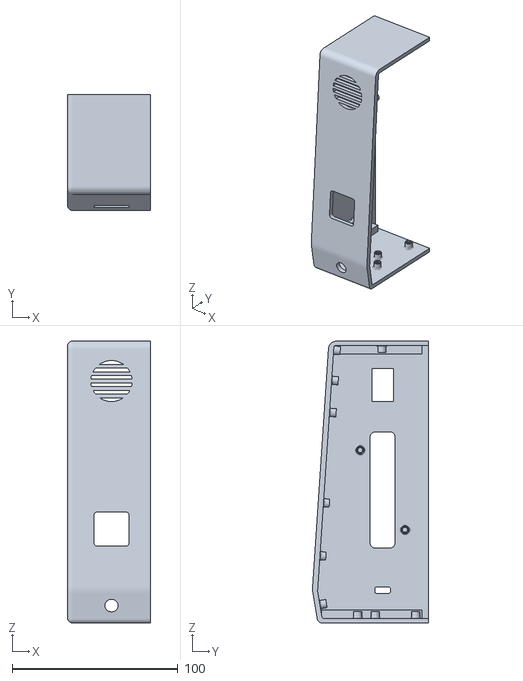
[picture p87: CAD file, 2026-08-17]
Prototype Development/3D Design/Version1p0/ESFGP02.stl
50.0 x 69.9 x 170.0
