randyzr/Graduation_Project/Prototype Development/3D Design/Version1p0/ESFGP09.stl

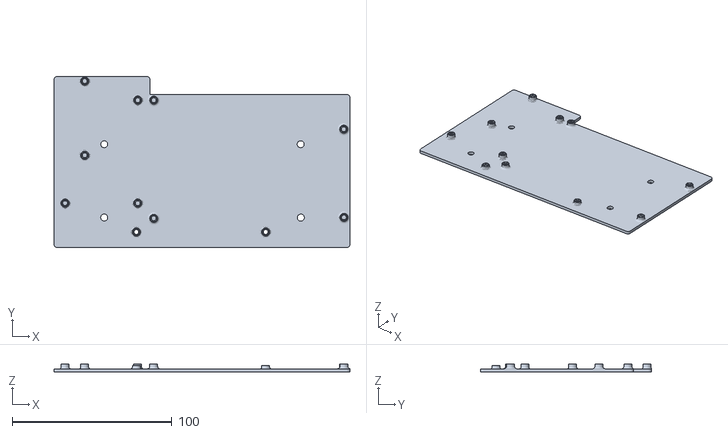
[picture p89: CAD file, 2026-08-17]
Prototype Development/3D Design/Version1p0/ESFGP09.stl
185.0 x 107.0 x 5.00
