randyzr/Graduation_Project/Prototype Development/3D Design/Version1p0/ESFGP05.stl

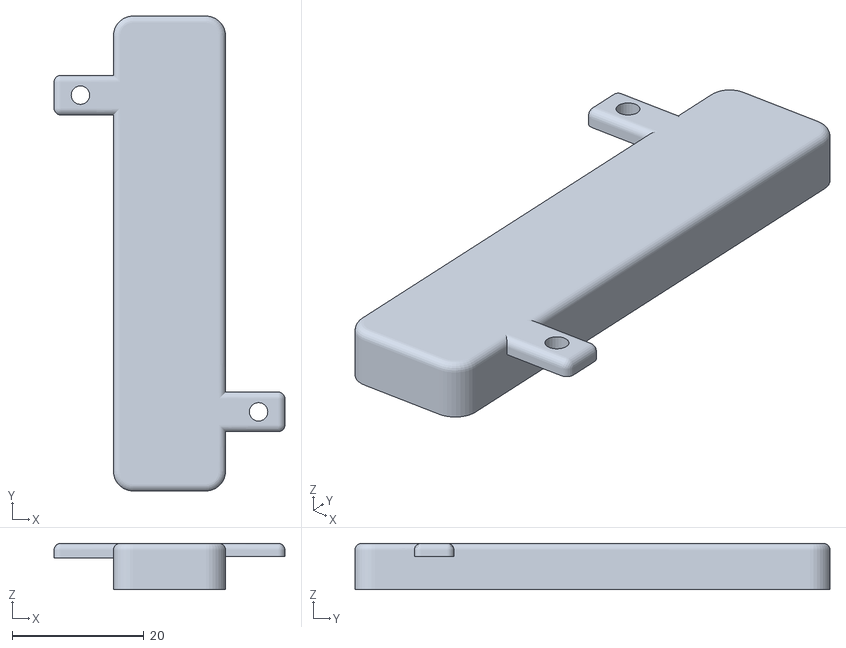
[picture p90: CAD file, 2026-08-17]
Prototype Development/3D Design/Version1p0/ESFGP05.stl
35.0 x 72.0 x 7.00
