randyzr/Graduation_Project/Prototype Development/3D Design/Version1p0/ESFPG08.stl

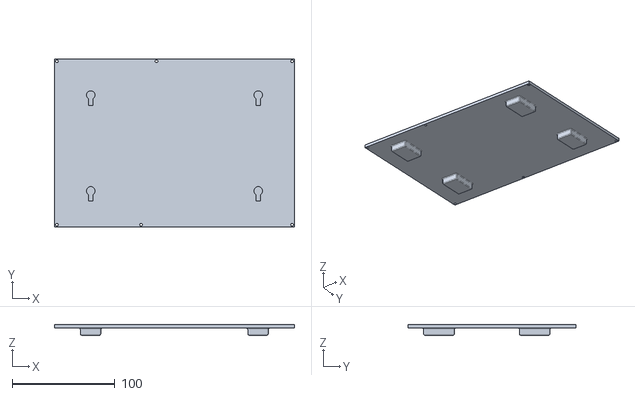
[picture p91: CAD file, 2026-08-17]
Prototype Development/3D Design/Version1p0/ESFPG08.stl
234.0 x 164.0 x 10.4
