randyzr/Graduation_Project/Prototype Development/3D Design/Version1p0/ESFGP01.stl

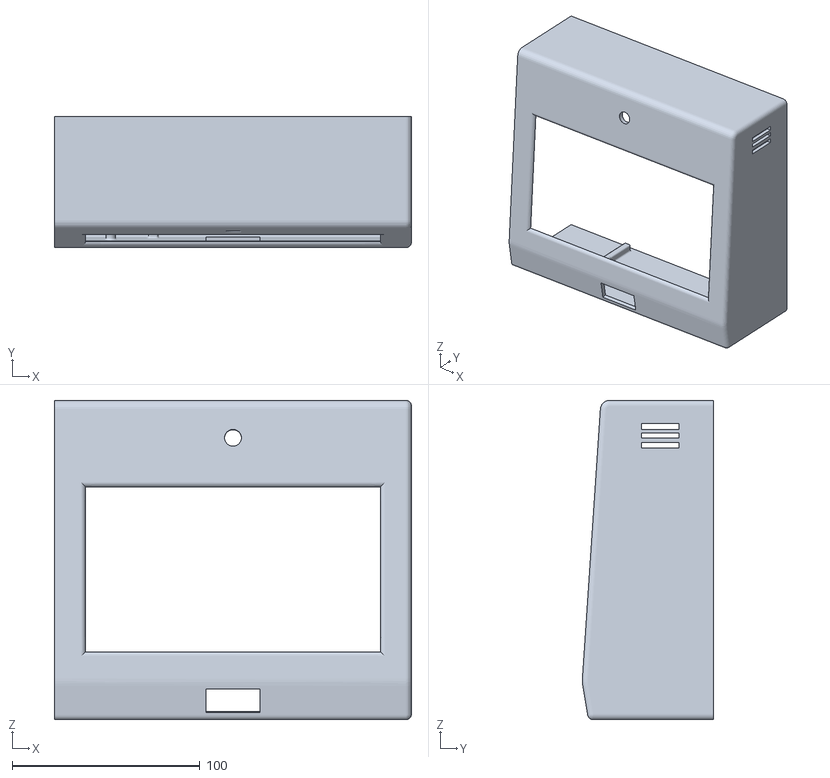
[picture p92: CAD file, 2026-08-17]
Prototype Development/3D Design/Version1p0/ESFGP01.stl
190.0 x 69.9 x 170.0
