randyzr/Graduation_Project/Prototype Development/3D Design/Version1p0/ESFGP07.stl

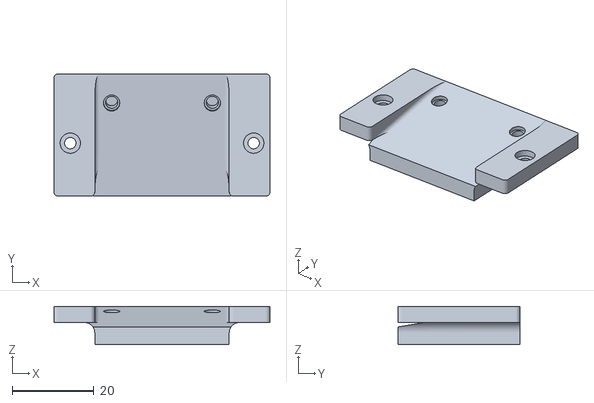
[picture p94: CAD file, 2026-08-17]
Prototype Development/3D Design/Version1p0/ESFGP07.stl
53.0 x 30.0 x 9.35
