randyzr/Graduation_Project/Prototype Development/3D Design/Version1p0/ESFGP06_p2.stl

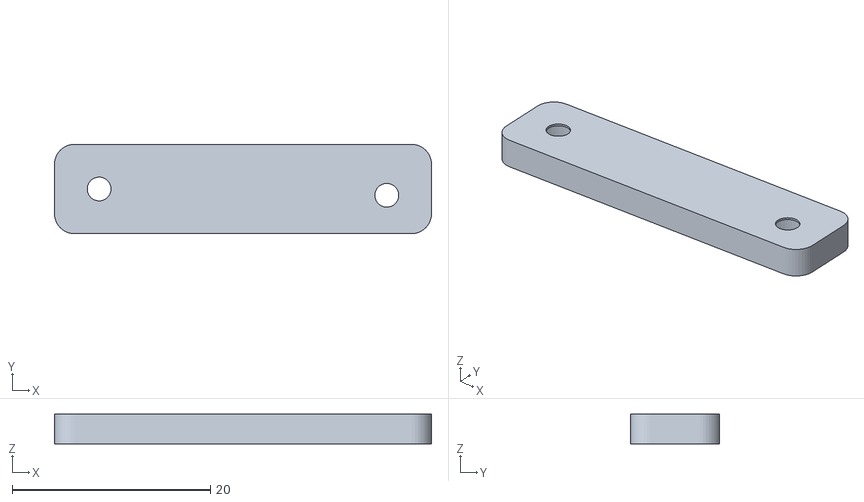
[picture p95: CAD file, 2026-08-17]
Prototype Development/3D Design/Version1p0/ESFGP06_p2.stl
38.0 x 9.00 x 3.00
