randyzr/Graduation_Project/Prototype Development/3D Design/Version1p0/ESFPG03.stl

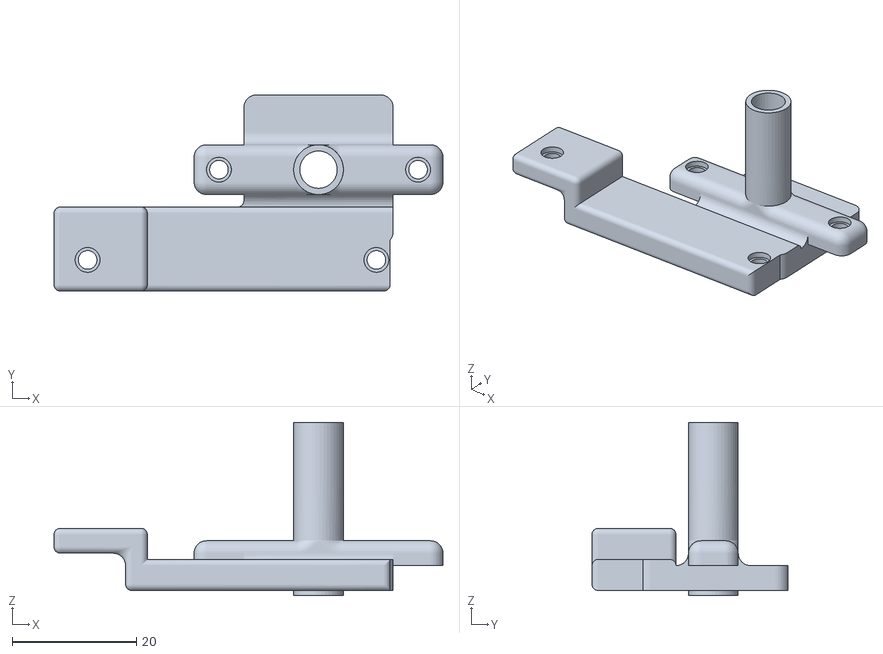
[picture p96: CAD file, 2026-08-17]
Prototype Development/3D Design/Version1p0/ESFPG03.stl
62.5 x 31.5 x 27.8
