randyzr/Graduation_Project/Prototype Development/3D Design/Version1p0/ESFGP04.stl

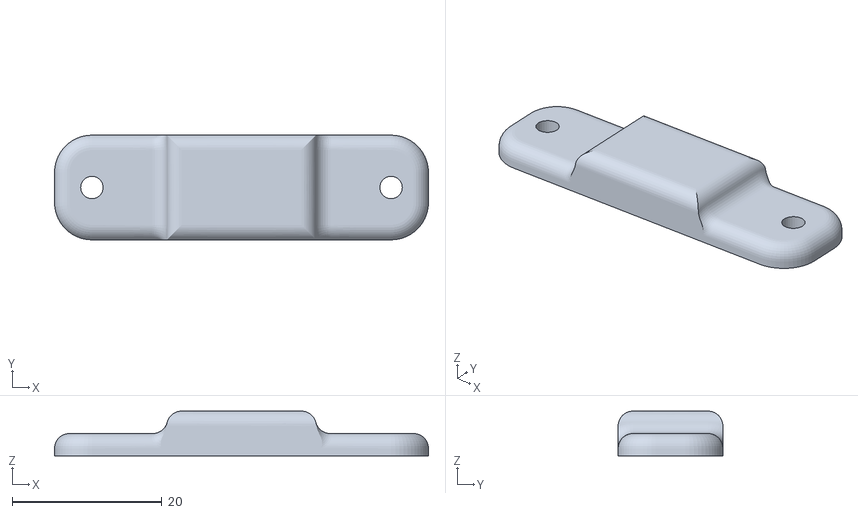
[picture p97: CAD file, 2026-08-17]
Prototype Development/3D Design/Version1p0/ESFGP04.stl
50.0 x 14.0 x 6.00
