randyzr/Graduation_Project/Prototype Development/3D Design/Version1p0/ESFGP08_p1.stl

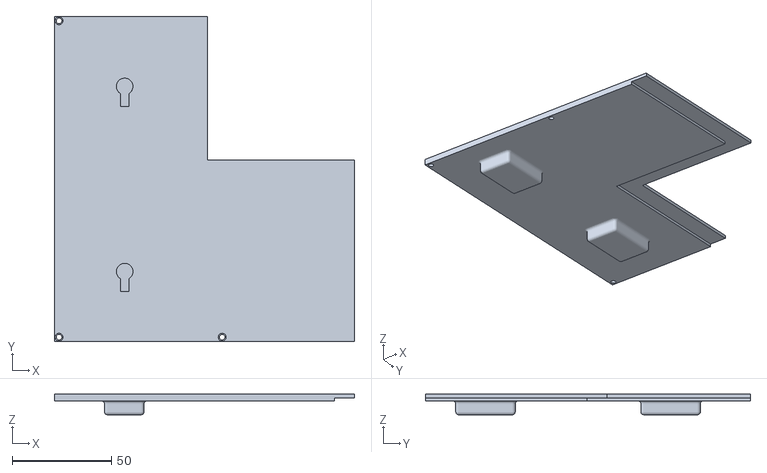
[picture p100: CAD file, 2026-08-17]
Prototype Development/3D Design/Version1p0/ESFGP08_p1.stl
151.2 x 164.0 x 10.4
