randyzr/Graduation_Project/Prototype Development/3D Design/Version1p0/ESFGP08_p2.stl

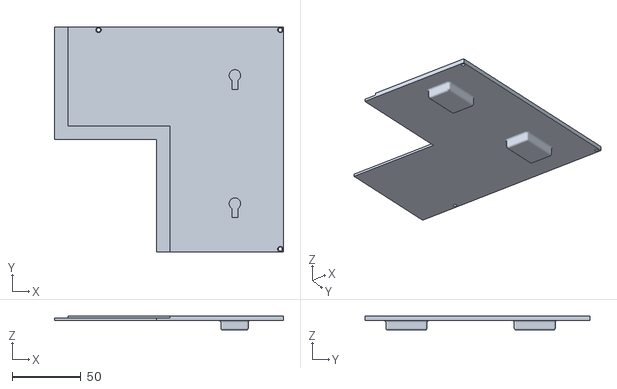
[picture p101: CAD file, 2026-08-17]
Prototype Development/3D Design/Version1p0/ESFGP08_p2.stl
166.6 x 164.0 x 10.4
