randyzr/Graduation_Project/Prototype Development/3D Design/Version1p0/Drawings/Wall1.0.pdf

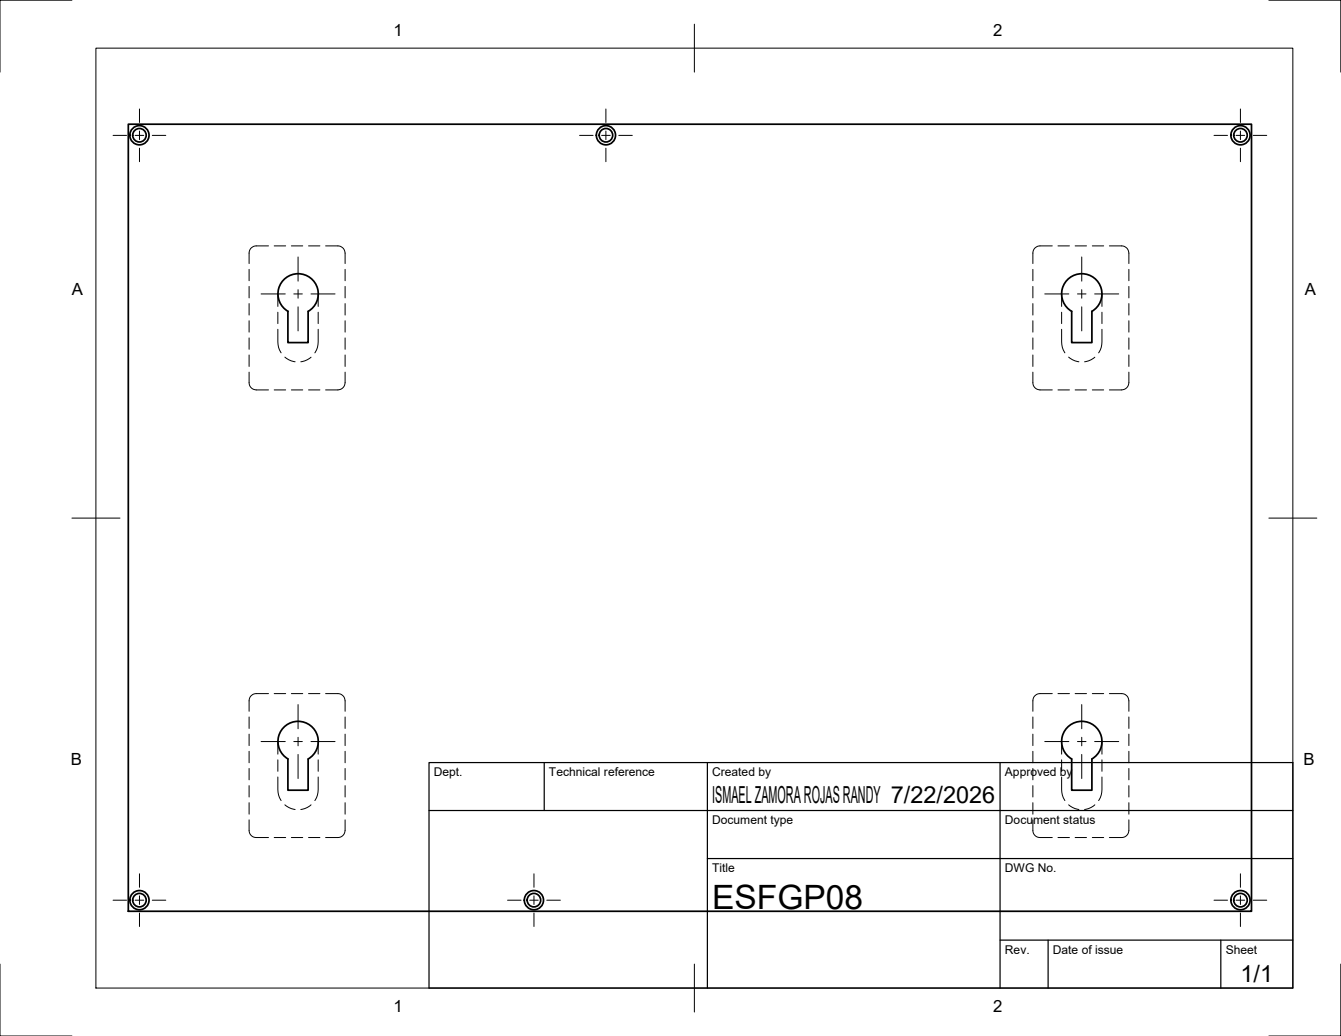
[picture p102: page 1]
Dept.; Technical reference; Created by; Approved by; Document type; Document status; Title; DWG No.; Rev.; Date of issue; Sheet

ISMAEL ZAMORA ROJAS RANDY
