randyzr/Graduation_Project/Prototype Development/Simulations/Ohmmeter_Circuit_1p0.asc

R1: res; 35000000; tol=10 pwr=0.1
R2: res; 2000000; tol=0.1 pwr=0.1
R3: res; 20000; tol=0.1 pwr=0.1
R4: res; 10000; tol=0.1 pwr=0.1
U1: ADA4622
U2: ADA4622
V1: voltage; 32
V2: voltage; 1.6
Named nets: 0
.tran 0.1
