randyzr/Graduation_Project/(list of files, drawings)

Other design files:
Prototype Development/PCBs/Versions/ESD_System.eprj
