randyzr/Graduation_Project/(commit log)

2026-06-23 Backup current graduation project draft
2026-08-17 Replace repository with current graduation project
    [ESD_System.eprj, ESFGP01.stl, ESFGP02.stl, ESFGP04.stl, ESFGP05.stl, ESFGP06_p1.stl, ESFGP06_p2.stl, ESFGP06_p3.stl]
